AK-Homberger/NMEA2000-SeatalkNG-AlarmBuzzer/(commit log)

2020-08-04 Changed TX pin from 2 to 5. Buzzer pin from 5 to 15.
2022-02-05 Use new ESP32-API function name "esp_efuse_mac_get_default(chipid);"
2023-05-03 Correction in line 195 (see Issue #1)
    [NMEA2000-Alarm-Buzzer.ino]
